Galacs/glcs-kicad-libraries/README.md

# Galacs' Kicad libraries

These are symbols, footprints and 3D models which are used in my designs
