Galacs/glcs-kicad-libraries/(commit log)

2025-11-27 footprint: update 3d model paths
2025-11-27 footprint: add TI SOT-23-THIN-8
2025-11-27 symbol: update footprint library
2025-11-27 symbol: add DRV8701 H-bridge gate driver
2025-11-28 symbol: update DRV8701 gnd pin location
2025-11-28 symobol: regorganize drv8701 power pins
2025-11-29 symbol: add TPS56A37 10A buck converter
2025-11-29 footprint add RPA0010A for TPS56A37 with 3d model
2025-11-29 symbol: fix TPS56A37 hidden gnd pin location
2025-12-01 symbol/footprint: add 5015 micro mini keystone testpoint
2025-12-02 symbol: fix DRV8701 gnd pad pin number
2025-12-02 3dmodel: add Vishay PowerPak 1212-8
2025-12-07 symbol: add BQ77905 battery protector
2025-12-08 symbol: add DRV8311H 3-phase brushless DC motor driver
2025-12-08 symbol(DRV8311): change power pins positions
2025-12-08 symbol: add 3 phase brushless motor
2025-12-10 symbol: add CP2102-GMR UART to USB
2025-12-10 symbol: add RF switch connector
2025-12-10 footprint/3dmodel: add Murata MM8030-2610 rf switch connector
2025-12-10 footprint(MM8030-2610RK0): use recommended solder stencil
2025-12-11 footprint: add 18650 battery holder BH-18650-B1BA002
2025-12-12 symbol: add DRV8424RGER stepper driver
2025-12-12 footprint: add Ti RGE0024B for DRV8424RGER
2025-12-12 symbol(DRV8424RGER): move CPH pin
2025-12-12 symbol(DRV8424RGER): move power pins
2025-12-21 footprint: add JST_XH 6 pin stepper connector
2025-12-21 footprint: add TI RRW0024A for DRV8311
2025-12-21 symbol(DRV8311H): set RRW0024A footprint
2025-12-21 footprint(RRW0024A): update thermal vias locations
2025-12-21 footprint(186500): improve silkscreen
2026-01-08 footprint: add Thin PAD M3
2026-01-09 symbol: add AS5600 magnetic sensor
2026-01-10 footprint: add Connector_Pad_1x03
2026-01-10 footprint(Connector_Pad_1x03): add courtyard and silkscreen
2026-01-10 footprint: add MLT-5020 magnetic buzzer
2026-01-11 3dmodel: add XT30-M connector
2026-01-15 footprint: add power tool battery holder
2026-01-15 footprint: add TI RPW0010A
2026-01-15 symbol(TPS259472x): set RPW0010A footprint
2026-02-18 footprint(RPW0010A): fix silkscreen
2026-02-22 3dmodel: add XT30PW-M connector
2026-04-12 3dmodel: add Omron B3F-4055 button
2026-04-12 3dmodel: add SHOUHAN MSK12C02 slide switch
2026-04-14 3dmodel: add PJ-320D-A jack connector
2026-04-14 3dmodel: add EC11E-05SW encoder footprint
2026-05-20 symbol: add espressif esp32-c5 mcu
2026-05-20 symbol(esp32-c5): reorganize gnd pins
2026-05-20 symbol(esp32-c5): regorganize power pins
2026-05-26 3dmodel: add Murata MM8930-2620 rf connector
2026-05-26 footprint: add Murata_MM8030-26102610 rf connector
2026-05-26 footprint: add Silicontra SX1262ZTR8 LoRa Module
2026-05-26 footprint(SX1262TR8): reorder pin numbers
2026-05-26 3dmodel: add BWSMA KWE Z001 SMA connector
2026-05-26 3dmodel: add HDC2080DMBR TI humidity sensor
2026-05-27 footprint(SX1262TR8): add courtyard
2026-05-29 3dmodel: add R-RJ11R06P-A800 connector
2026-06-25 3dmodel: add KYOCERA 009159010061916 edge connector
2026-06-25 footprint: add KYOCERA_AVX9159-006 edge connector
2026-06-27 symbol: add TPSM84338 3A power module
2026-06-27 footprint: add TPSM84338
2026-06-27 footprint(TPSM84338): fix vias pad numbers
2026-06-27 schem: add LM73100 ideal diode
2026-06-29 symbol: add MX25947 5A 24v efuse
2026-07-23 symbol: add NextPM air sensor footprint
2026-07-23 symbol: add HS20HS072RX 320x240 ST7789 SPI TFT display
2026-07-24 symbol(nextpm): add shield gnd connection
2026-07-28 symbol: add Sciosence ens16x mox air sensor
2026-07-28 schem: add SYS1002-H2 mox air sensor
2026-07-29 footprint: add Sciosense ENS160 air sensor
2026-07-29 symbol(ENS160): add footprint
2026-07-29 3dmodel: add MiCS-5524 air sensor
2026-07-29 footprint(ENS160): fix courtyard
2026-09-13 symbol(ST7789): break out LED-
2026-09-13 footprint: add Q&J CR2032-BS-6-1 battery holder
2026-09-13 footprint: add MYOUNG BS-08-B2AA016 cr2032 holder
2026-09-14 symbol(TPS259470x: update pin names
2026-09-23 symbol(SIM7080G): update sim pin order
2026-09-24 footprint: add SIM70890G modem
2026-09-24 symbol(SIM7080G): add footprint
2026-09-24 footprint(BS-08-B2AA016): add 3d model
2026-09-27 symbol: add GS3912APG 7segment led display
2026-09-29 footprint: add GS3911AG 7 segment display
2026-10-03 footprint(ENS160): fix courtyard weight
2026-10-04 footprint: add DRR0012E LM7480 oring
2026-10-06 schem: add hotswap mosfets
2026-10-10 footprint: add TI RGE0024M 24 pins
2026-10-10 schematic: add TPS25983 20A efuse
2026-10-10 symbol(LM5122): fix vcc power direction
2026-10-10 symbol(LM7480): update epad pin number
2026-10-10 3dmodel: add AMASS XT30PW-F connector
2026-10-10 footprint(RGE0024M): fix vias pad numbers
2026-10-11 footprint(TPS25983): fix power pins stacking
2026-10-16 3dmodel: add K6-6133D04 switch with led
2026-10-16 footprint: add SW_LED_K6-6133d04
2026-10-16 symbol(K6-6133D04): add footprint
2026-10-16 footprint(K6-6133D04): fix pin ordering
